Radu-Caragin/Licenta_Caragin_Crasovan_Radu/README.md

https://github.com/Radu-Caragin/Licenta_Caragin_Crasovan_Radu

În fișierul cod_sursa_placi se afla doua fisiere: cod_sursa_arduino și cod_sursa_nodemcu. Pentru a încărca codul pe plăcile aferente este nevoie de Arduino IDE.

Pentru a încărca codul sursă pentru Arduino Mega, este nevoie să conectăm placa de dezvoltare la calculator folosind un cablu USB. Apoi, în Arduino IDE la secțiunea "Select board" trebuie selectată placa Arduino Mega conectată. Pe urmă, se adaugă codul sursă aferent plăcii, se instalează bibliotecile necesare din meniul "Manage libraries", apăsăm pe butonul "Upload".

Pentru a încărca codul sursă pentru NodeMCU, este nevoie să conectăm placa de dezvoltare la calculator folosind un cablu micro USB. Apoi, în Arduino IDE la secțiunea "Select board" trebuie selectată placa NodeMCU conectată. Pe urmă, se adaugă codul sursă aferent plăcii, se instalează bibliotecile necesare din meniul "Manage libraries", apăsăm pe butonul "Upload".

Pentru încărcarea aplicației mobile este nevoie de Android Studio și un dispozitiv Android ce are ca sistem minim de operare instalat Android 6.0. Din setările telefonului trebuie să pornim setarea "Developer Options". Apoi, conectăm telefonul la calculator folosind un cablu USB. În Android Studio încărcam toate fișierele cu excepția folder-ului "cod_sursa_placi" și  "latex_documentatie_fisiere". Pe urmă, după încărcarea fișierelor, selectăm din lista de dispozitive conectate dispozitivul legat prin cablul USB. Ultimul pas este apăsarea butonului "Run" care încarcă aplicația pe dispozitiv. Pentru următoarele utilizări ale aplicației nu mai este nevoie să conectăm dispozitivul la calculator.

Pentru a vizualiza interfața Blynk este nevoie să accesăm pagina Blynk.cloud pentru varianta web, iar pentru varianta mobile trebuie descărcată aplicația Blynk.
