Radu-Caragin/Licenta_Caragin_Crasovan_Radu/latex_documentatie_fisiere/declaratie_autenticitate_radu.pdf

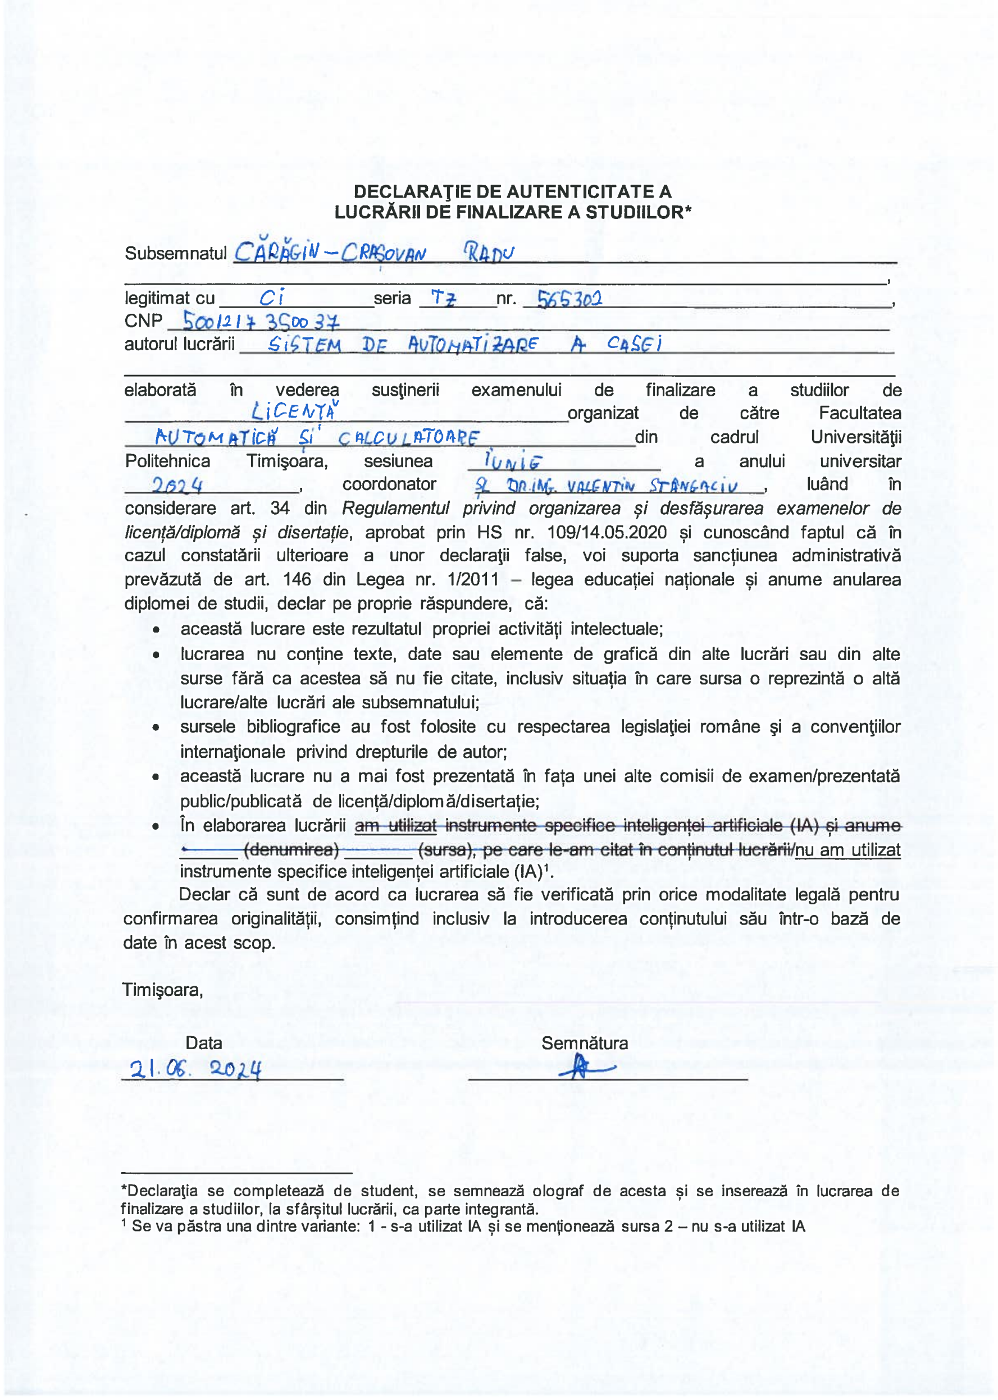
[picture p41: page 1]
