Radu-Caragin/Licenta_Caragin_Crasovan_Radu/latex_documentatie_fisiere/bachelors_ro/images/arduino_uno.png

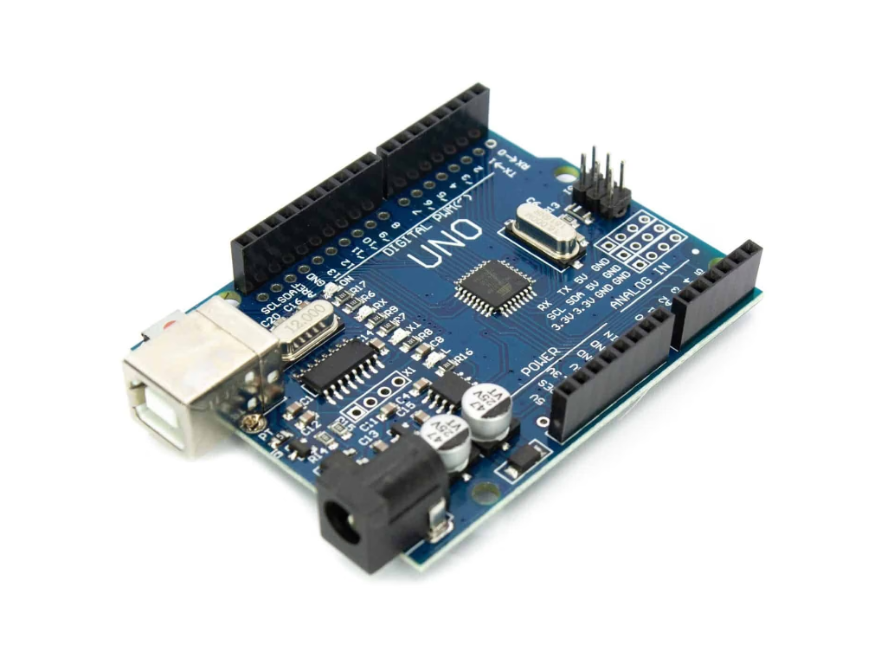
latex_documentatie_fisiere/bachelors_ro/images/arduino_uno.png
