Radu-Caragin/Licenta_Caragin_Crasovan_Radu/latex_documentatie_fisiere/bachelors_ro/images/bt_pico_scatter.png

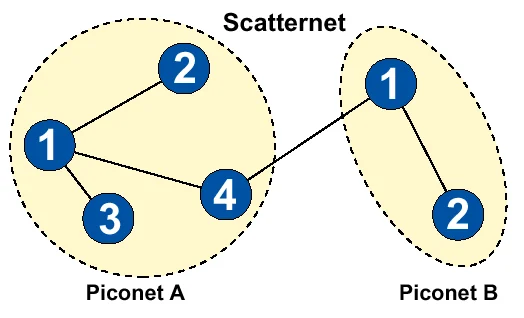
latex_documentatie_fisiere/bachelors_ro/images/bt_pico_scatter.png
